westonb/open-pmic/verification/eff_plot.csv

Vin | Rload | Temp | Process Corner | Iin | Iout | Ibias | Vmax | Vmin | Vpeak | IL_Max | Il_Min | Eff
3.3 | 5.4 | 70 | ss | 0.1979765 | 0.334269 | 0.00209841 | 1.817316 | 1.803338 | 1.957908 | 0.7368067 | -0.02483559 | 0.9138594223615364
3.3 | 5.7514792899408285 | 70 | ss | 0.1854683 | 0.313732 | 0.002084444 | 1.811205 | 1.803457 | 1.96788 | 0.7685699 | -0.02514974 | 0.9146603099986287
3.3 | 6.151898734177216 | 70 | ss | 0.1728335 | 0.293267 | 0.002069809 | 1.808028 | 1.803507 | 1.977816 | 0.8104639 | -0.02515829 | 0.9166923460460946
3.3 | 6.612244897959184 | 70 | ss | 0.160179 | 0.272838 | 0.002055004 | 1.806335 | 1.803684 | 1.985522 | 0.734531 | -0.02490945 | 0.9193964406631647
3.3 | 7.147058823529412 | 70 | ss | 0.1475476 | 0.252423 | 0.002040151 | 1.805459 | 1.803774 | 1.992423 | 0.7037653 | -0.04596631 | 0.9225188135815364
3.3 | 7.776 | 70 | ss | 0.1350299 | 0.232017 | 0.002024997 | 1.804946 | 1.803933 | 2.002668 | 0.790061 | -0.02466762 | 0.9255233254524943
3.3 | 8.526315789473685 | 70 | ss | 0.1225743 | 0.211613 | 0.002009857 | 1.804954 | 1.804092 | 2.010073 | 0.7957409 | -0.02484355 | 0.9286869527531172
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
