westonb/open-pmic/verification/ss_ff_corners.csv

Vin | Rload | Temp | Process Corner | Iin | Iout | Ibias | Vmax | Vmin | Vpeak | IL_Max | Il_Min | Eff
3.3 | 10 | 25 | ss | 0.1033135 | 0.180369 | 0.001970502 | 1.804272 | 1.803501 | 2.028361 | 0.7715251 | -0.1403165 | 0.9363699552896418
3.3 | 10 | 25 | ff | 0.102683 | 0.180342 | 0.002022234 | 1.804046 | 1.803163 | 1.951437 | 0.844172 | -0.07817536 | 0.9412639632444042
3.3 | 10 | 70 | ss | 0.1038157 | 0.180452 | 0.001986607 | 1.804777 | 1.80433 | 2.022997 | 0.703258 | -0.061777 | 0.9326406105108784
3.3 | 10 | 70 | ff | 0.103033 | 0.180409 | 0.002040389 | 1.804554 | 1.803937 | 1.94291 | 0.8716259 | -0.1048042 | 0.938663041620569
3.3 | 1000 | 25 | ss | 0.001335882 | 0.00180583 | 0.001826527 | 1.805963 | 1.805662 | 2.097916 | 0.7642321 | -0.9871329 | 0.3124796575916804
3.3 | 1000 | 25 | ff | 0.001262217 | 0.00180504 | 0.00187725 | 1.805189 | 1.804865 | 1.999376 | 0.8108362 | -0.6647035 | 0.3144877971614001
3.3 | 1000 | 70 | ss | 0.001342543 | 0.00180764 | 0.001842403 | 1.80789 | 1.807145 | 2.089895 | 0.8059669 | -0.7963756 | 0.3108908016118022
3.3 | 1000 | 70 | ff | 0.001271043 | 0.00180645 | 0.001895199 | 1.806587 | 1.806266 | 1.988555 | 0.7713066 | -0.516628 | 0.31231572074172714
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
