westonb/open-pmic/(commit log)

2021-04-04 schematic capture of bias circuit and folded cascode opa with nmos input
    [bias_circuit.sch, bias_circuit_tb.sch, folded_cascode_n_in.sch]
2021-04-05 added p input opamp and current sensing test circuit
    [bias_circuit.sch, current_sense_poc.sch, folded_cascode_n_in.sch, folded_cascode_p_in.sch, folded_cascode_p_in_tb.sch]
2021-04-05 added more functional blocks
    [comparator_functional.sch, comparator_functional_tb.sch, folded_cascode_n_in.sch, folded_cascode_n_in_tb.sch, power_stage.sch, power_stage_tb.sch, switch_test.sch, switch_test_NMOS.sch]
2021-04-06 added initial functional model of system
    [integration_poc.sch, switch_control.sch, switch_control_tb.sch]
2021-04-08 refactored opamp bias circuitry
    [bias_circuit_tb.sch, current_sense_poc.sch, folded_cascode_n_in.sch, folded_cascode_n_in_tb.sch, folded_cascode_p_in.sch, folded_cascode_p_in_tb.sch]
2021-04-09 Initial comparator design
    [comparator.sch, comparator_tb.sch]
2021-04-11 added comparator with output buffer and slope compensation to system simulation
    [comparator_w_obuff.sch, comparator_w_obuff_tb.sch, current_sense_poc.sch, integration_poc.sch]
2021-04-12 concept design now uses only sky130 components
    [integration_poc.sch]
2021-04-19 added schmittbuf symbol
    [schmittbuf_tb.sch]
2021-04-20 refactored and modularized design
    [analog_subsystem.sch, bias_circuit.sch, bias_circuit_tb.sch, bias_distribution.sch, comparator_functional.sch, comparator_w_obuff.sch, current_sense.sch, current_sense_ac_bode.sch]
2021-04-21 added initial waffel fet layout
2021-04-21 added simple model of IO pads and bugfix for imonitor connection
    [current_sense.sch, full_system_tb.sch]
2021-04-22 completed oscillator
    [oscillator.sch, oscillator_tb.sch, rampgen.sch, rampgen_tb.sch, schmittbuf.sch]
2021-04-27 improved external compensation network and added externally adjustable current limiting
    [analog_subsystem.sch, bias_distribution.sch, current_sense.sch, folded_cascode_n_in_tb.sch, folded_cascode_p_in_tb.sch, full_system.sch, full_system_tb.sch, modulator.sch]
2021-04-28 added second stage esd structures
    [cascode_bias.sch, current_sense.sch, current_sense_ac_bode.sch, folded_cascode_n_in.sch, folded_cascode_p_in.sch, full_system.sch, full_system_tb.sch, power_stage.sch]
2021-05-01 Delete comparator.sch
    Deleted old version
    [comparator.sch]
2021-05-01 Delete comparator_tb.sch
    Deleted older version
    [comparator_tb.sch]
2021-05-01 added level shifting of compensation signal
    [analog_subsystem.sch, bias_distribution.sch, cascode_bias.sch, folded_cascode_p_in.sch, full_system_tb.sch, modulator.sch]
2021-05-01 cleaning up comparator directory
    [comparator_w_obuff.sch, comparator_w_obuff_tb.sch, voltage_source.sch]
2021-05-01 added initial scripts for automatic corner sweeps
    [NMOS_diode_test.sch, N_diode_test.sch, P_diode_test.sch, full_system_tb.sch, switch_test_NMOS.sch, switch_test_PMOS.sch]
2021-05-02 minor bugfix for verification
    [full_system_tb.sch]
2021-05-02 refactored analog test benches
    [current_sense_ac.sch, current_sense_ac_phase_margin.sch]
2021-05-03 added simulation data and efficiency plot
    [current_sense_ac.sch, current_sense_ac_phase_margin.sch, eff_plot.csv, folded_cascode_n_in_tb.sch, ss_ff_corners.csv]
2021-05-03 added verification testing report
    [vcomp_limit_test.sch]
2021-05-07 cascode bias circuit routed and passes lvs
    [cascode_bias.sch]
2021-05-08 folded cascode p in routed and passes LVS
    [cascode_bias.sch, folded_cascode_p_in.sch]
2021-05-11 finished layout of n input folded cascode
    [folded_cascode_n_in.sch]
2021-05-11 widened locali on bias circuit
    [folded_cascode_p_in_tb.sch]
2021-05-12 refactored script for waffel FET generation without edge terminations
2021-05-17 added bus bars to waffle fet gen
2021-05-23 finised layout of gate drive, passes LVS
    [gate_drive.sch, power_stage.sch, power_stage_tb.sch]
2021-05-23 layout of bias distribution circuitry, passes DRC
    [bias_distribution.sch]
2021-05-23 comparator schematic with dummies
    [comparator_w_obuff_4LVS.sch]
2021-05-23 set up comparator for LVS
    [comparator_w_obuff_4LVS.sch]
2021-05-23 current sense routed and passes lvs
    [current_sense.sch]
2021-05-24 fixed dummies. passes lvs.
    [comparator_w_obuff_4LVS.sch]
2021-05-24 matched ports of comparator sym and sch
    [comparator_w_obuff.sch, comparator_w_obuff_and_wo_dummies.sch, comparator_w_obuff_tb.sch]
2021-05-24 oscillator schematic with 300kHz freq and 0.1 duty cycle
    [counter.sch, oscillator_tb.sch, rampgen.sch, schmittbuf.sch]
2021-05-24 routed modulator
    [modulator.sch]
2021-05-24 fixed name mismatch for comparator schematic
    [comparator_w_obuff.sch]
2021-05-27 initial layout for switch control block
    [switch_control.sch]
2021-05-27 switch control module passes LVS
    [switch_control.sch]
2021-05-29 shifted m2 resistor to stop DRC false flags
    [analog_subsystem.sch, full_system.sch, full_system_tb.sch, modulator.sch, power_stage.sch]
2021-06-01 refactored waffle fet gen script and build nmos and pmos waffles
2021-06-14 oscillator initial layout
    [comparator_w_obuff_tb.sch, rampgen_w_dummies.sch, schmittbuf_tb.sch]
2021-06-15 changes to oscillator
    [rampgen_wo_dummies.sch]
2021-06-15 correct oscillator schematic
    [oscillator.sch, oscillator_tb.sch, rampgen.sch, rampgen_w_dummies.sch]
2021-06-16 completed oscillator layout
    [oscillator.sch, rampgen.sch]
2021-06-16 pushing missing files
    [oscillator.sch, oscillator_tb.sch, rampgen.sch]
2021-06-16 fixed body connections
    [oscillator.sch, rampgen.sch]
2021-06-17 corrected number of fingers
    [oscillator_tb.sch, rampgen.sch]
2021-06-17 fixed oscillator layout
    [oscillator_tb.sch]
2021-06-17 fixed oscillator design
    [oscillator_tb.sch]
